HackHobby-Lab/BLE-Sound-Sensor/README.rst

.. zephyr:: adc + BLE 
   :name: BLE-Sound-Sensor
   :relevant-api: adc_interface, zephyr/Bluetooth and GATT

   Read analog inputs from ADC channel and send data to Mobile app over BLE thorugh specified UUIDs.

Dev Notes
=============

Make sure to build it for the specific board and do take Tea while working
