HackHobby-Lab/BLE-Sound-Sensor/PCB-Files/3D_PCB1_2025-10-26 (1).png

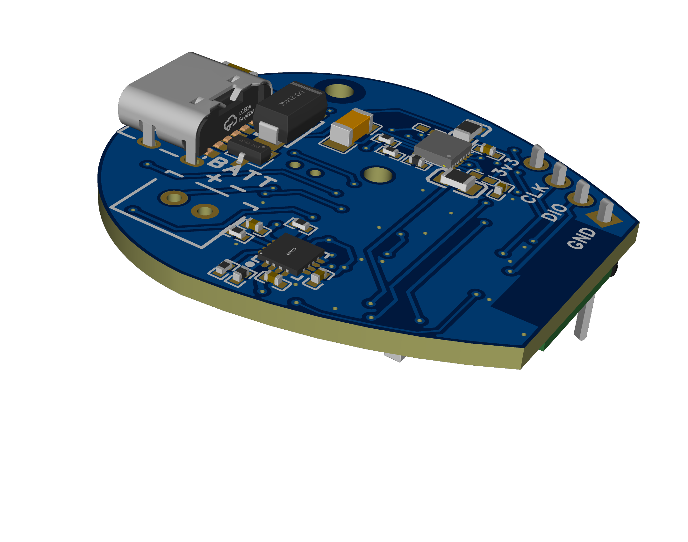
PCB-Files/3D_PCB1_2025-10-26 (1).png
