HackHobby-Lab/BLE-Sound-Sensor/PCB-Files/BOM_Board1_PCB1_2025-10-26.xlsx

No. | Quantity | Comment | Designator | Footprint | Value | Manufacturer Part | Manufacturer | Supplier Part | Supplier | Datasheet | Mounting Type | Name | Primary Category | Secondary Category
1 | 2 | Solder_Bridge | A/R,GAIN | Solder_bridge
2 | 4 | 4.7uF | C3,C4,C5,C6 | C0402 | 4.7uF | CL05A475MP5NRNC | SAMSUNG(三星) | C23733 | LCSC | https://atta.szlcsc.com/upload/public/pdf/source/20160103/1457707710457.pdf |  | 4.7uF | Capacitors | Multilayer Ceramic Capacitors MLCC - SMD/SMT
3 | 1 | 22uF | C7 | C0603 |  | CL10A226MQ8NRNC | SAMSUNG | C59461 | LCSC |  |  | 22uF
4 | 1 | 100nF | C13 | C0402 |  | CL05B104KO5NNNC | SAMSUNG(三星) | C1525 | LCSC |  |  | 100nF
5 | 3 | 1uF | C15,C16,C17 | C0402 | 1uF | CL05A105KA5NQNC | SAMSUNG(三星) | C52923 | LCSC | https://atta.szlcsc.com/upload/public/pdf/source/20160103/1457707735223.pdf |  | 1uF | Capacitors | Multilayer Ceramic Capacitors MLCC - SMD/SMT
6 | 3 | 100nF | C18,C22,C23 | C0402_NEW |  | CL05B104KO5NNNC | SAMSUNG | C1525 | LCSC |  |  | 100nF
7 | 2 | 2.2uF | C24,C25 | C0402 | 2.2uF | CL05A225KP5NSNC | SAMSUNG(三星) | C107369 | LCSC | https://atta.szlcsc.com/upload/public/pdf/source/20160218/1457707763339.pdf |  | 2.2uF | Capacitors | Multilayer Ceramic Capacitors MLCC - SMD/SMT
8 | 1 | 470nF | C26 | C1206 | 470nF | GRM31C5C1E474JE01L | muRata(村田) | C6049896 | LCSC | https://atta.szlcsc.com/upload/public/pdf/source/20230811/B562120698C33FBC22B686C4E8ED41C5.pdf |  | 470nF | Capacitors | Multilayer Ceramic Capacitors MLCC - SMD/SMT
9 | 1 | SS34_C8678 | D2 | DO-214AC_L4.3-W2.7-LS5.3-RD |  | SS34 | MDD | C8678 | LCSC |  |  | SS34_C8678
10 | 1 | DAN222 | D3 | SOT-523-3_L1.6-W0.8-P1.00-LS1.6-BR |  | DAN222 | CJ(江苏长电/长晶) | C68999 | LCSC | https://atta.szlcsc.com/upload/public/pdf/source/20160516/1463363921260.pdf |  | DAN222 | Diodes | Switching Diodes
11 | 1 | SP0502BAHTG | D5 | SOT-23-3_L2.9-W1.3-P1.90-LS2.4-BR |  | SP0502BAHTG | Littelfuse(美国力特) | C207261 | LCSC | https://atta.szlcsc.com/upload/public/pdf/source/20180516/C207265_281EDDBFBBFB54F41B8F928A92EA5876.pdf |  | SP0502BAHTG | Circuit Protection | ESD and Surge Protection (TVS/ESD)
12 | 1 | PZ254V-11-04P | IN1 | HDR-TH_4P-P2.54-V-M |  | PZ254V-11-04P | XFCN(兴飞) | C2691448 | LCSC | https://atta.szlcsc.com/upload/public/pdf/source/20200309/C492403_F9F19131791D08044AD4F84F8E751A34.pdf | Straight | PZ254V-11-04P | Connectors | Pin Headers
13 | 2 | CBG201209U601T | L1,L2 | L0805 |  | CBG201209U601T | FH(风华) | C124100 | LCSC | https://atta.szlcsc.com/upload/public/pdf/source/20180917/C294510_876BBCD5BD7C9EF2E8468360D8BC49D0.pdf |  | CBG201209U601T | Filters | Ferrite Beads
14 | 1 | NCD0402R1 | LED1 | LED0402-RD |  | NCD0402R1 | 国星光电 | C130719 | LCSC | https://atta.szlcsc.com/upload/public/pdf/source/20200820/C130719_A72EA5A7FEC83C35856EA0453E4EE775.pdf |  | NCD0402R1 | Optoelectronics | LED Indication - Discrete
15 | 1 | KT-0603G | LED2 | LED0603-RD |  | KT-0603G | KENTO | C12624 | LCSC | https://item.szlcsc.com/datasheet/KT-0603G/13258.html |  | KT-0603G
16 | 1 | KT-0603R | LED54 | LED0603-RD |  | KT-0603R | KENTO | C2286 | LCSC | https://atta.szlcsc.com/upload/public/pdf/source/20160616/1466072038404.pdf |  | KT-0603R | Optocoupler/LED/Digital Tube/Photoelectric Device | Light Emitting Diodes (LED)
17 | 1 | B4013AM423-093 | MIC1 | MIC-SMD_BD4.0_B4013AM423-093-1 |  | B4013AM423-093 | Goertek(歌尔) | C233790 | LCSC | https://atta.szlcsc.com/upload/public/pdf/source/20180813/C233790_F5B864A011312A7BF4487DA03A0EE7FB.pdf |  | B4013AM423-093 | Audio Products / Vibration Motors | Microphones
18 | 3 | 10kΩ | R4,R145,R146 | R0402 | 10kΩ | 0402WGF1002TCE | UNI-ROYAL(厚声) | C25744 | LCSC | https://atta.szlcsc.com/upload/public/pdf/source/20200306/C422600_1E6D84923E4A46A82E41ADD87F860B5C.pdf |  | 10kΩ | Resistors | Chip Resistor - Surface Mount
19 | 2 | 2.2kΩ | R5,R7 | R0402 | 2.2kΩ | ERJPA2J222X | PANASONIC(松下) | C427211 | LCSC | https://item.szlcsc.com/datasheet/ERJPA2J222X/421301.html |  | 2.2kΩ
20 | 1 | 46.4kΩ | R8 | R0402 | 46.4kΩ | ERJ2RKF4642X | PANASONIC(松下) | C416544 | LCSC | https://atta.szlcsc.com/upload/public/pdf/source/20190902/C416544_D8DEE4661B7BB3BE6E0B9DEBD6F2D950.pdf |  | 46.4kΩ
21 | 1 | 1.18kΩ | R10 | R0402 | 1.18kΩ | RC0402FR-071K18L | YAGEO(国巨) | C273709 | LCSC | https://atta.szlcsc.com/upload/public/pdf/source/20191125/C364360_EA870FADD46A2AD4DBE56DD50D360B3E.pdf |  | 1.18kΩ
22 | 2 | 5.1kΩ | R12,R13 | R0402 |  | 0402WGF5101TCE | UniOhm | C25905 | LCSC |  |  | 5.1kΩ
23 | 1 | 1kΩ | R20 | R0402 | 1kΩ | CRCW04021K00JNED | VISHAY(威世) | C191588 | LCSC | https://atta.szlcsc.com/upload/public/pdf/source/20200618/C481956_E25174B008CE8C884BEDD7D4D15E674F.pdf |  | 1kΩ | Resistors | Chip Resistor - Surface Mount
24 | 1 | 3.3kΩ | R22 | R0201 | 3.3kΩ | 0201WMF3301TEE | UNI-ROYAL(厚声) | C270350 | LCSC | https://atta.szlcsc.com/upload/public/pdf/source/20200306/C422600_1E6D84923E4A46A82E41ADD87F860B5C.pdf |  | 3.3kΩ | Resistors | Chip Resistor - Surface Mount
25 | 1 | 6.8kΩ | R23 | R0201 | 6.8kΩ | RC-01W6801FT | FH(风华) | C321006 | LCSC | https://atta.szlcsc.com/upload/public/pdf/source/20140616/1457707091974.pdf |  | 6.8kΩ | Resistors | Chip Resistor - Surface Mount
26 | 1 | 3kΩ | R27 | R0201 | 3kΩ | RC0201FR-073KL | YAGEO(国巨) | C142016 | LCSC | https://atta.szlcsc.com/upload/public/pdf/source/20180821/C275644_0D56F95EFF785E7D9A1FEF436B37DA78.pdf |  | 3kΩ | Resistors | Chip Resistor - Surface Mount
27 | 1 | 1MΩ | R118 | R0402 | 1MΩ | 0402WGF1004TCE | UNI-ROYAL(厚声) | C26083 | LCSC | https://atta.szlcsc.com/upload/public/pdf/source/20200306/C422600_1E6D84923E4A46A82E41ADD87F860B5C.pdf |  | 1MΩ | Resistors | Chip Resistor - Surface Mount
28 | 1 | 1.13kΩ | R147 | R0402 | 1.13kΩ | 0402WGF1131TCE | UNI-ROYAL(厚声) | C67014 | LCSC | https://atta.szlcsc.com/upload/public/pdf/source/20200306/C422600_1E6D84923E4A46A82E41ADD87F860B5C.pdf |  | 1.13kΩ
29 | 1 | 100kΩ | R151 | R0402 | 100kΩ | RC0402FR-07100KL | YAGEO(国巨) | C60491 | LCSC | https://atta.szlcsc.com/upload/public/pdf/source/20180927/C295883_E8D83085EA81BD7DE0B2B681138C15EE.pdf |  | 100kΩ | Resistors | Chip Resistor - Surface Mount
30 | 1 | 150kΩ | R152 | R0402 | 150kΩ | RC0402FR-07150KL | YAGEO(国巨) | C93947 | LCSC | https://atta.szlcsc.com/upload/public/pdf/source/20180821/C275644_0D56F95EFF785E7D9A1FEF436B37DA78.pdf |  | 150kΩ | Resistors | Chip Resistor - Surface Mount
31 | 1 | 2.2kΩ | R153 | R0402 | 2.2kΩ | RC0402FR-072K2L | YAGEO(国巨) | C114762 | LCSC | https://atta.szlcsc.com/upload/public/pdf/source/20180821/C275644_0D56F95EFF785E7D9A1FEF436B37DA78.pdf |  | 2.2kΩ | Resistors | Chip Resistor - Surface Mount
32 | 1 | 0Ω | R154 | R0402 | 0Ω | RC0402FR-070RL | YAGEO(国巨) | C106231 | LCSC | https://item.szlcsc.com/datasheet/RC0402FR-070RL/107446.html |  | 0Ω | Resistors | Chip Resistor - Surface Mount
33 | 1 | Test-Point | RST | Test-Point-1mm
34 | 1 | BQ24075RGTR | U2 | QFN-16_L3.0-W3.0-P0.50-TL-EP1.7 |  | BQ24075RGTR | TI(德州仪器) | C15464 | LCSC | http://www.ti.com/cn/lit/gpn/bq24075 |  | BQ24075RGTR | Power Management (PMIC) | Battery Management
35 | 1 | XL-1010RGBC-WS2812B | U3 | LED-SMD_4P-L1.0-W1.0-TL_XL-1010RGBC-WS2812B |  | XL-1010RGBC-WS2812B | XINGLIGHT(成兴光) | C5349953 | LCSC | https://atta.szlcsc.com/upload/public/pdf/source/20240218/17D2BD8F4295D202E0F5662BF6E5539A.pdf |  | XL-1010RGBC-WS2812B | Optoelectronics | RGB LEDs(Built-in IC)
36 | 1 | NINA-B406-00B | U4 | LGA-60_L15.0-W10.0-NINA-B406-00B |  | NINA-B406-00B | u-blox | 672-NINA-B406-00BCT-ND | Digikey | https://content.u-blox.com/sites/default/files/NINA-B40_DataSheet_UBX-19049405.pdf |  | NINA-B406-00B
37 | 1 | NCP176 | U53 | XDFN-6_L1.2-W1.2-P0.40-BL-EP |  | NCP176 | onsemi(安森美) | C233363 | LCSC | https://atta.szlcsc.com/upload/public/pdf/source/20221020/5DD9CF373AFB0F635C513C626C2C0431.pdf |  | NCP176 | Power Management (PMIC) | Voltage Regulators - Linear, Low Drop Out (LDO) Regulators
38 | 1 | MAX9814ETD+T | U55 | TDFN-14_L3.0-W3.0-P0.40-BL-EP |  | MAX9814ETD+T | ADI(亚德诺)/MAXIM(美信) | C41714 | LCSC | https://atta.szlcsc.com/upload/public/pdf/source/20150124/1457707262509.pdf |  | MAX9814ETD+T | Amplifiers/Comparators | Audio Amplifiers
39 | 1 | GT-TC029A-H040-L1A | U57 | SW-SMD_L4.0-W3.0-LS5.0-EH |  | GT-TC029A-H040-L1A | G-Switch(品赞) | C22379546 | LCSC | https://atta.szlcsc.com/upload/public/pdf/source/20240409/E5A7D7DFA85769F3A69D0F93F06072A5.pdf |  | GT-TC029A-H040-L1A | Switches | Tactile Switches
40 | 1 | TYPE-C 6P(073) | USB2 | TYPE-C-SMD_TYPE-C-6P_5 |  | TYPE-C 6P(073) | SHOU HAN(首韩) | C668623 | LCSC | https://atta.szlcsc.com/upload/public/pdf/source/20200618/C668623_A4B260DED7AC1949BAC6AE39E9F4CD80.pdf |  | TYPE-C 6P(073) | Connectors | USB Connectors
