HackHobby-Lab/BLE-Sound-Sensor/PCB-Files/3D_PCB1_2025-10-26.step

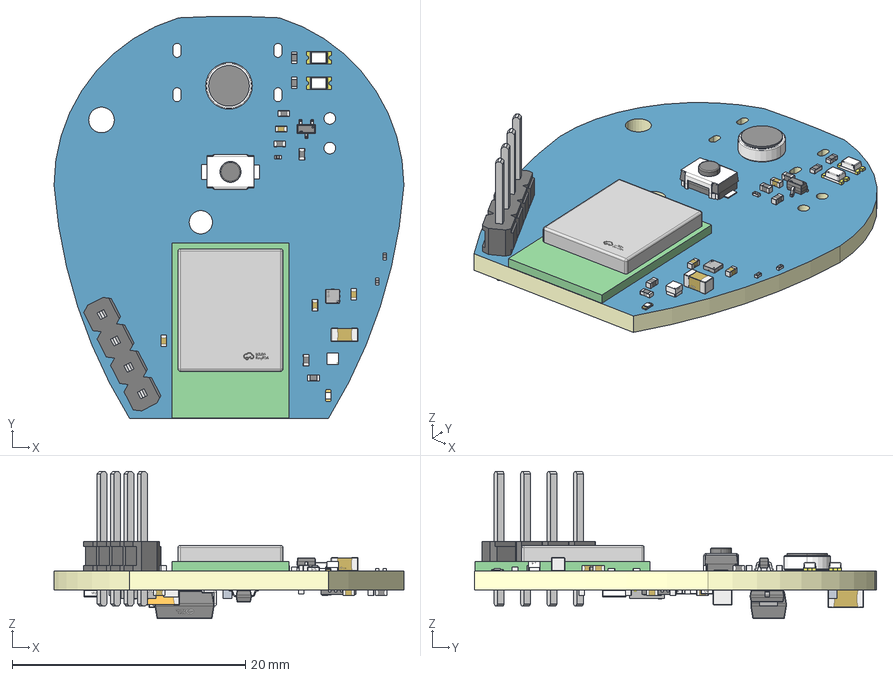
[picture p3: CAD file, 2025-10-26]
PCB-Files/3D_PCB1_2025-10-26.step
30.0 x 34.4 x 12.6 mm
Board~gTt6
TopCopper~gTt6
BottomCopper~gTt6
TopFpcStiffener~gTt6
BottomFpcStiffener~gTt6
C0603~C0603~gTt6
LED0402-RD~LED0402_L1.0-W0.5-H0.2~gTt6
C0402~C0402_L1.0-W0.5-H0.5~gTt6 x 9
C0402~C0402~gTt6
R0402~R0402_L1.0-W0.5-H0.4~gTt6 x 8
SOT-523-3_L1.6-W0.8-P1.00-LS1.6-BR~SOT-523-3P_ L1.6-W0.8-H0.9-LS1.6-P0.50~gTt6
DO-214AC_L4.3-W2.7-LS5.3-RD~DO-214AC_L4.3-W2.7-LS5.3-RD~gTt6
C1206~C1206_L3.2-W1.6-H1.3~gTt6
LGA-60_L15.0-W10.0-NINA-B406-00B~LGA-60_L15.0-W10.0-NINA-B406-00B~gTt6
L0805~R0805_L2.0-W1.3-H0.6~gTt6 x 2
LED0603-RD~LED0603-RD~gTt6 x 2
LED-SMD_4P-L1.0-W1.0-TL_XL-1010RGBC-WS2812B~LED-SMD_4P-L1.0-W1.0-TL_ XL-1010RGBC-WS2812B~gTt6
HDR-TH_4P-P2.54-V-M~HDR-TH_4P-P2.54-M-LI-1X4P~gTt6
SOT-23-3_L2.9-W1.3-P1.90-LS2.4-BR~SOT-23-3P_ L2.9-W1.3-H1.0-LS2.4-P0.95~gTt6
QFN-16_L3.0-W3.0-P0.50-TL-EP1.7~QFN-16_L3.0-W3.0-H0.9-P0.50~gTt6
R0201~R0201_L0.6-W0.3-H0.3~gTt6 x 3
R0402~R0402_L1.0-W0.5-H0.5~gTt6 x 6
MIC-SMD_BD4.0_B4013AM423-093-1~MIC-SMD_BD4.0-H1.5_B4013AM423-093~gTt6
XDFN-6_L1.2-W1.2-P0.40-BL-EP~XDFN-6_L1.2-W1.2-H0.4-P0.4-BL-EP~gTt6
SW-SMD_L4.0-W3.0-LS5.0-EH~SW-SMD_L4.0-W3.0-H2-LS5.0-EH~gTt6
TYPE-C-SMD_TYPE-C-6P_5~TYPE-C-SMD_TYPE-C-6P_5~gTt6
TDFN-14_L3.0-W3.0-P0.40-BL-EP~TDFN-14_L3.0-W3.0-H0.8-P0.40-BL-EP~gTt6
