HackHobby-Lab/BLE-Sound-Sensor/Firmware-guide/Firmware Flashing Guide -JackJack.pdf

# Firmware Flashing Guide

## 1. Install the Required Software

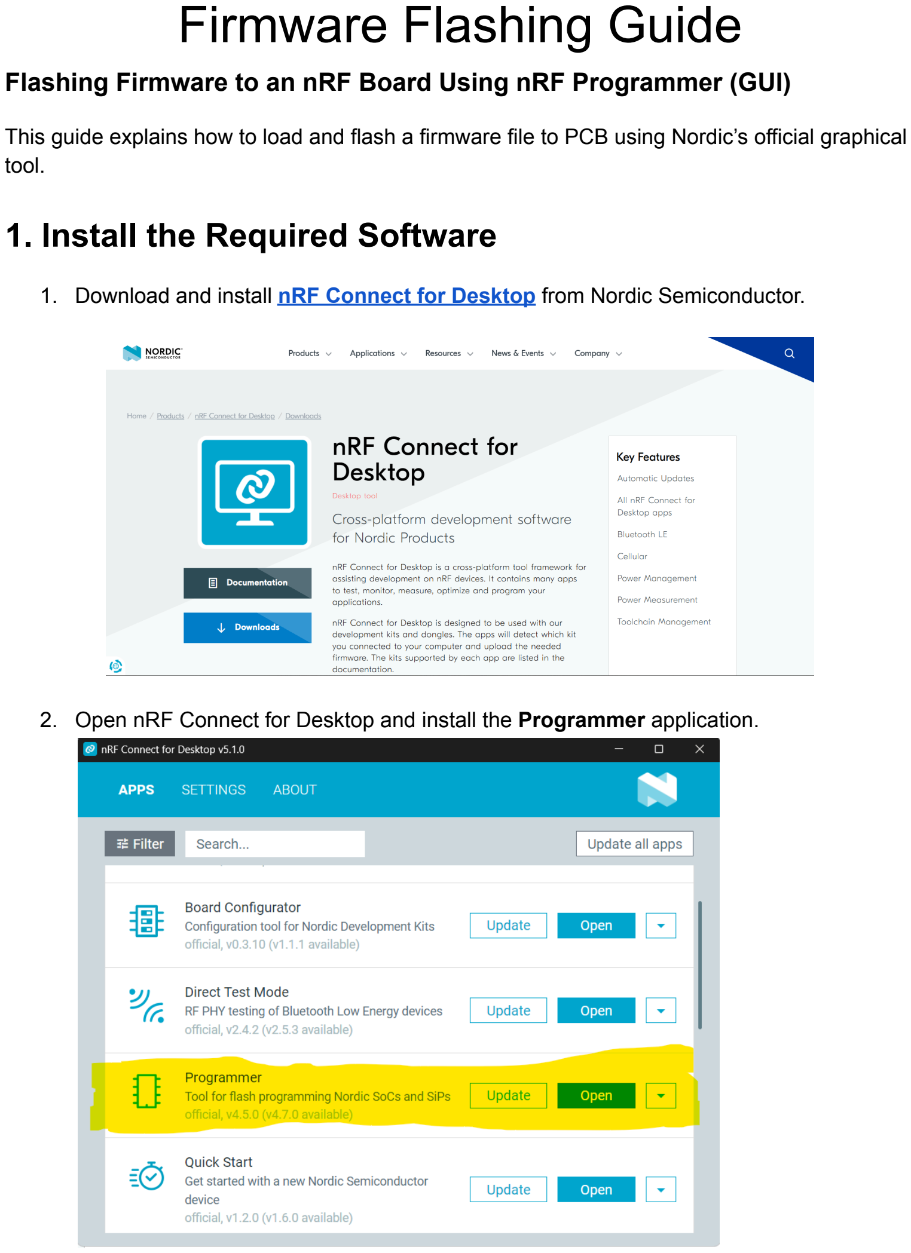
[picture p4: page 1]

Flashing Firmware to an nRF Board Using nRF Programmer (GUI)

This guide explains how to load and flash a firmware file to PCB using Nordic’s official graphical tool.

1. Download and install nRF Connect for Desktop (https://www.nordicsemi.com/Products/Development-tools/nrf-connect-for-desktop/download) from Nordic Semiconductor.
2. Open nRF Connect for Desktop and install the Programmer application.

## 2. Connect the nRF Board

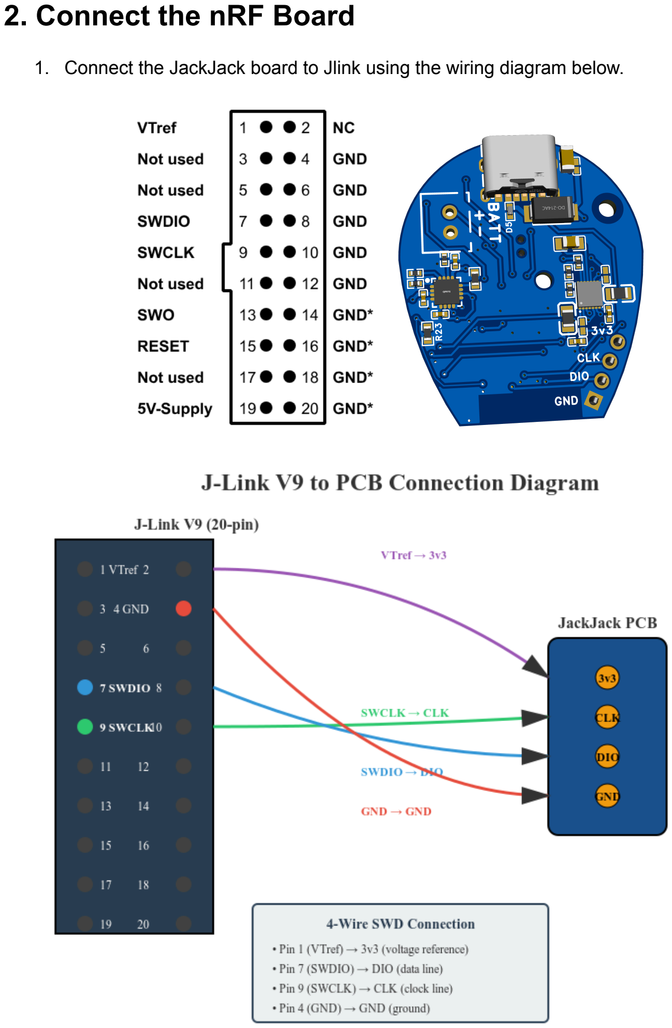
[picture p5: page 2]

1. Connect the JackJack board to Jlink using the wiring diagram below.

After this done;

2. Connect Jlink to the Laptop
3. Open the Programmer application. [Mentioned in previous image]
4. Click Select device and choose the detected J-Link device corresponding to your board.

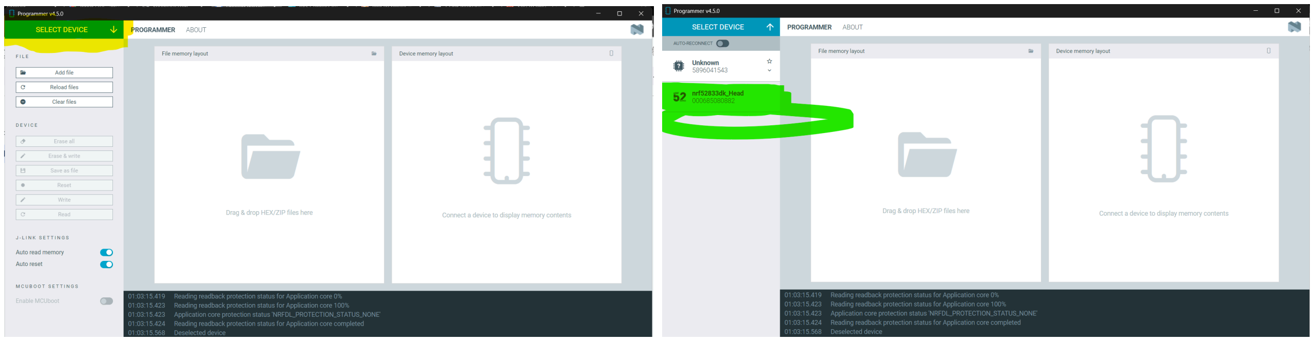
[picture p6: figure]

## 3. Load the Firmware File

1. Build the firmware using your development environment.

Locate the generated file found in:

firmware/zephyr.hex

## 4. Flash the Firmware

Click Erase & Write to begin programming.
This performs a full chip erase, writes the firmware, and verifies the operation.

## 5. Run the Application

Once flashing completes,you can wait for a few seconds and then unplug the JLink and plug back in.
You’ll see the Mic-Sense in your App. Make sure your BLE and Location services are on and also your app has all the permissions.
