HackHobby-Lab/BLE-Sound-Sensor/(commit log)

2025-02-17 Initial commit for adc
2025-04-29 ADC battery test is working
2025-07-13 custom pcb working, RGB, Button, ble working
2025-09-27 long press power off feature added
2025-09-28 led status with ble added
2025-10-26 pcb files added, configuration changed
    [3D_PCB1_2025-10-26.step, BOM_Board1_PCB1_2025-10-26.xlsx, PickAndPlace_PCB1_2025-10-26.xlsx]
2026-01-17 calibration of sensors
2026-02-10 Add PDM mic support and audio processing
    Enable PDM microphone and implement real-time RMS/dB processing.
    Changes:
    - nrf52833dk_nrf52833.overlay: enable &pdm0 and add pinctrl entries for default and sleep states.
    - prj.conf: enable console, printk, NRFX_PDM, clock control, increase stack/workqueue sizes, enable FPU, disable WS2812 and C++ lib.
    - src/main.c: integrate nrfx PDM driver (buffers, IRQ connect, handler), add RMS calculation and rms->dB conversion with peak tracking, start PDM and process audio in main loop (old ADC sampling path commented out), use printf for logging, automatically start BLE advertising on boot, and various minor refactors.
    Why: adds PDM MEMS microphone support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
